simonsilvalauinger/lamellen/hardware/export/stirn/lamellen_stirn_baugruppe.step

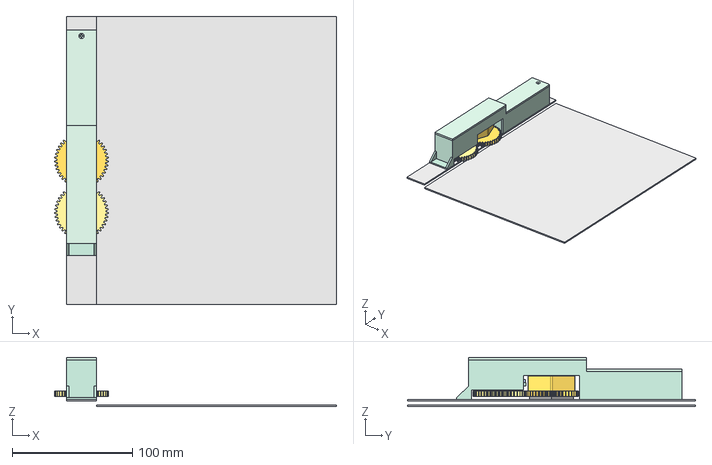
[picture p5: CAD file, 2026-10-22]
hardware/export/stirn/lamellen_stirn_baugruppe.step
235.0 x 240.0 x 41.0 mm
