simonsilvalauinger/lamellen/hardware/export/kalibrierung/huelse_breite.3mf

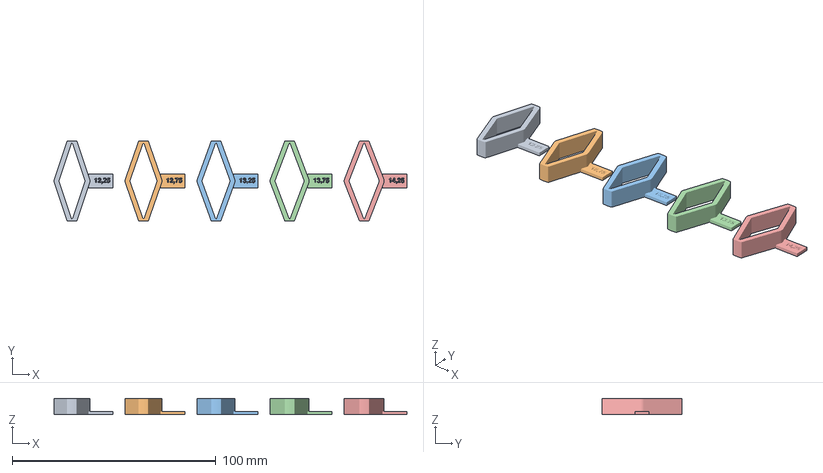
[picture p6: CAD file, 2026-10-22]
hardware/export/kalibrierung/huelse_breite.3mf
173.2 x 39.5 x 8.00 mm
huelse_breite_12_25
huelse_breite_12_75
huelse_breite_13_25
huelse_breite_13_75
huelse_breite_14_25
