simonsilvalauinger/lamellen/hardware/export/kalibrierung/stl/huelse_breite_12_75.stl

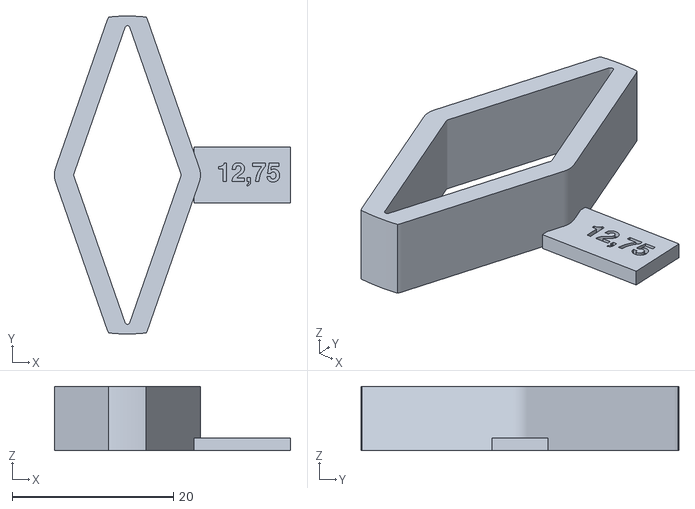
[picture p7: CAD file, 2026-10-22]
hardware/export/kalibrierung/stl/huelse_breite_12_75.stl
29.3 x 39.5 x 8.00
