simonsilvalauinger/lamellen/hardware/export/stirn/step/ritzel.step

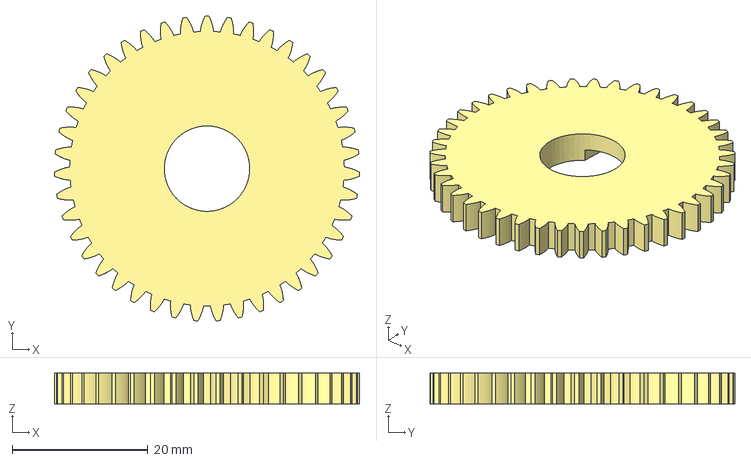
[picture p8: CAD file, 2026-10-22]
hardware/export/stirn/step/ritzel.step
45.0 x 45.0 x 4.50 mm
