simonsilvalauinger/lamellen/hardware/export/kalibrierung/huelse_laenge.3mf

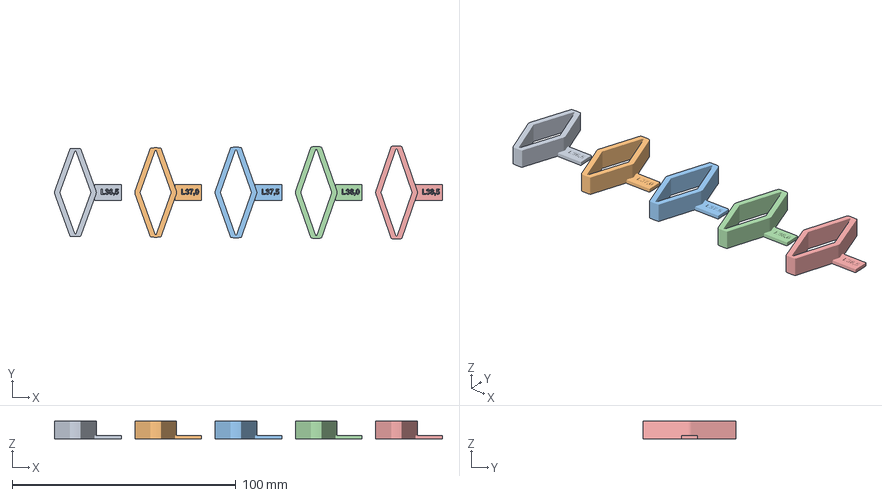
[picture p9: CAD file, 2026-10-22]
hardware/export/kalibrierung/huelse_laenge.3mf
173.2 x 41.5 x 8.00 mm
huelse_laenge_36_50
huelse_laenge_37_00
huelse_laenge_37_50
huelse_laenge_38_00
huelse_laenge_38_50
