simonsilvalauinger/lamellen/hardware/export/kalibrierung/stl/huelse_laenge_38_50.stl

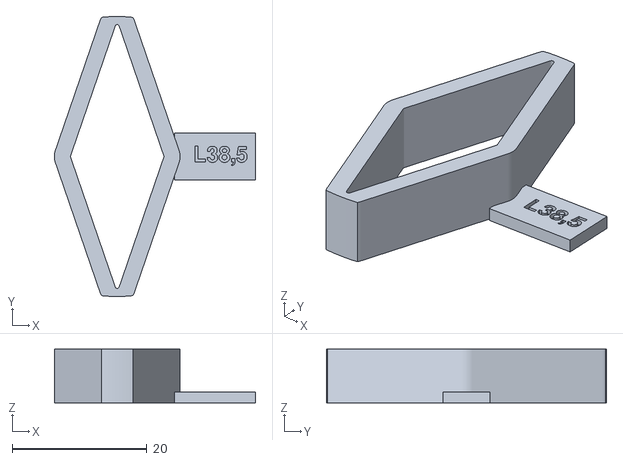
[picture p10: CAD file, 2026-10-22]
hardware/export/kalibrierung/stl/huelse_laenge_38_50.stl
29.8 x 41.5 x 8.00
