simonsilvalauinger/lamellen/hardware/export/stirn/lamellen_stirn.3mf

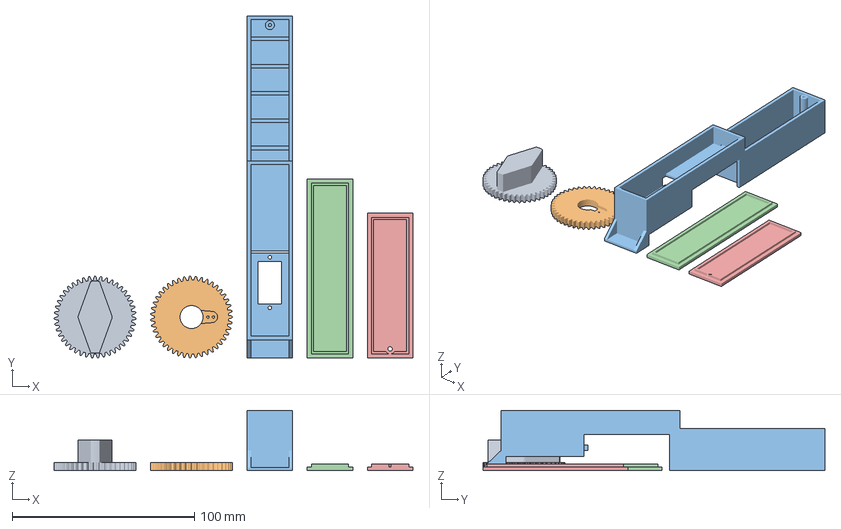
[picture p11: CAD file, 2026-10-22]
hardware/export/stirn/lamellen_stirn.3mf
196.9 x 187.8 x 33.0 mm
mitnehmer
ritzel
gehaeuse
deckel_turm
deckel_akku
