simonsilvalauinger/lamellen/hardware/export/stirn/step/gehaeuse.step

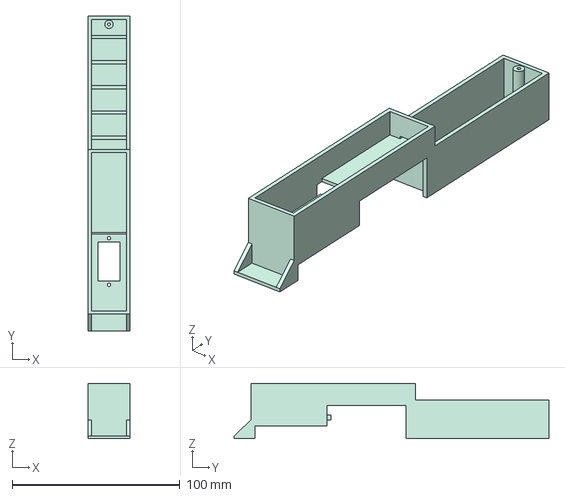
[picture p12: CAD file, 2026-10-22]
hardware/export/stirn/step/gehaeuse.step
25.0 x 187.8 x 33.0 mm
