simonsilvalauinger/lamellen/hardware/export/kalibrierung/stl/huelse_breite_13_75.stl

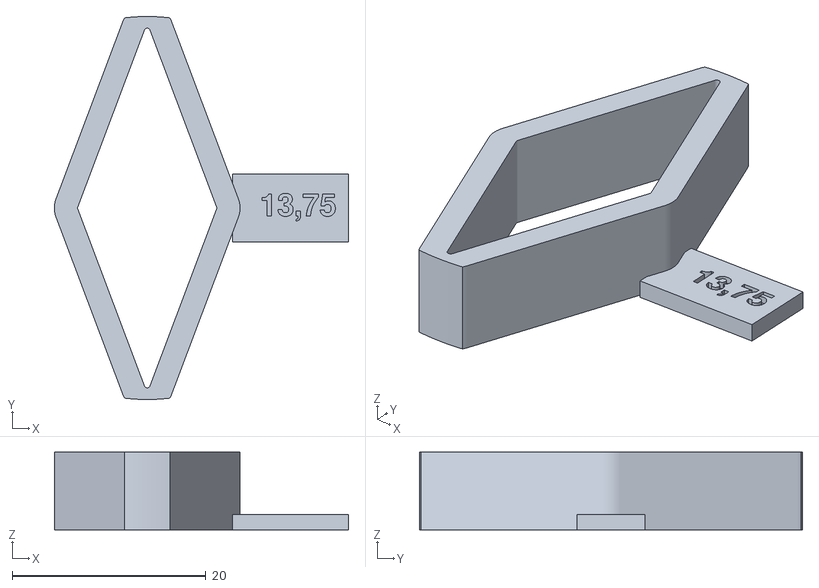
[picture p13: CAD file, 2026-10-22]
hardware/export/kalibrierung/stl/huelse_breite_13_75.stl
30.3 x 39.5 x 8.00
