simonsilvalauinger/lamellen/hardware/export/stirn/step/mitnehmer.step

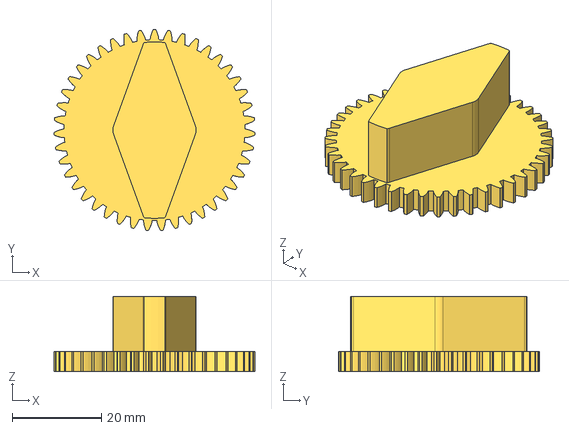
[picture p14: CAD file, 2026-10-22]
hardware/export/stirn/step/mitnehmer.step
45.0 x 45.0 x 16.8 mm
