simonsilvalauinger/lamellen/hardware/export/stirn/step/deckel_turm.step

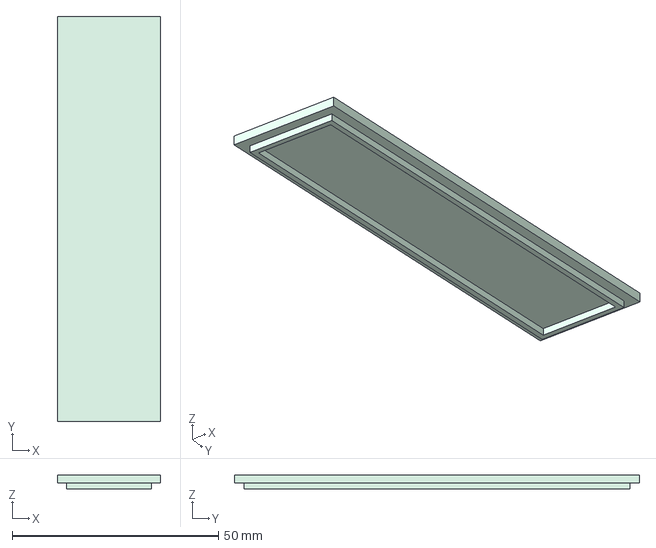
[picture p15: CAD file, 2026-10-22]
hardware/export/stirn/step/deckel_turm.step
25.0 x 98.2 x 3.50 mm
