simonsilvalauinger/lamellen/hardware/export/stirn/step/deckel_akku.step

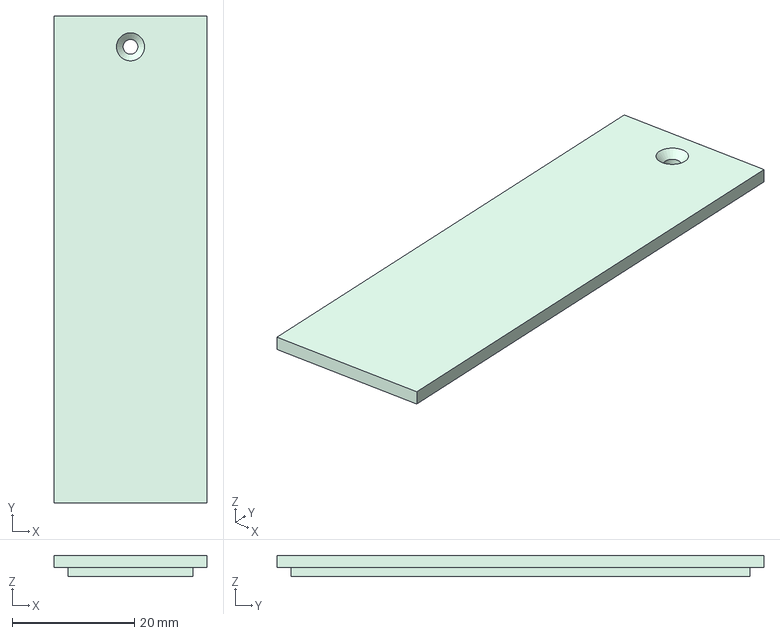
[picture p16: CAD file, 2026-10-22]
hardware/export/stirn/step/deckel_akku.step
25.0 x 79.5 x 3.50 mm
