simonsilvalauinger/lamellen/hardware/export/kalibrierung/stl/huelse_breite_14_25.stl

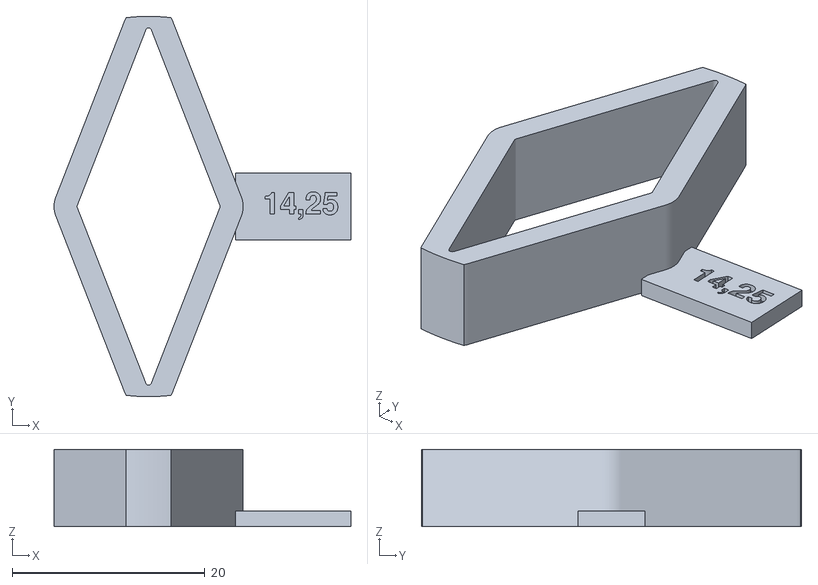
[picture p17: CAD file, 2026-10-22]
hardware/export/kalibrierung/stl/huelse_breite_14_25.stl
30.8 x 39.5 x 8.00
