simonsilvalauinger/lamellen/(list of files, cad)

Other CAD files:
hardware/export/kalibrierung/stl/huelse_breite_12_25.stl
hardware/export/kalibrierung/stl/huelse_breite_13_25.stl
hardware/export/kalibrierung/stl/huelse_laenge_36_50.stl
hardware/export/kalibrierung/stl/huelse_laenge_38_00.stl
hardware/export/kalibrierung/stl/huelse_laenge_37_00.stl
hardware/export/kalibrierung/stl/huelse_laenge_37_50.stl
hardware/export/stirn/stl/deckel_akku.stl
hardware/export/stirn/stl/deckel_turm.stl
hardware/export/stirn/stl/gehaeuse.stl
hardware/export/stirn/stl/mitnehmer.stl
hardware/export/stirn/stl/ritzel.stl
