simonsilvalauinger/lamellen/(commit log)

2026-10-21 Lösungskonzept für HA-gesteuerte Lamellen der Warmluftheizung
    Claude-Session: https://claude.ai/code/session_01V2ShDL9xXnCPpknpFR2EBe
2026-10-21 Knoten-Firmware (ESP32-C6, ESP-NOW, Deep-Sleep), Protokoll-Crate und OpenSCAD-Aktor
    - firmware/protocol: Nachrichten, Servo-Mathematik, Sicherheitslogik mit Tests
    - firmware/node: Status senden, Sollwert empfangen, Servo rampen, Deep-Sleep
    - hardware/lamellen_aktor.scad: parametrischer Mitnehmer für den Flügelmutter-Knopf,
    1:3-Getriebe, Halter für geklemmte Gitter
    - Konzept auf 45°-Drehknopf und geklemmte Gitter aktualisiert
    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
    [lamellen_aktor.scad]
2026-10-22 Aktor an echtes Gitter angepasst: Aufbau entlang des Rahmenrands
    Der Knopf sitzt auf dem Rahmenrand eines Edelstahlgitters, daneben steht
    teils ein Möbel. Neue Variante „direkt“ (Servo koaxial, Standard) und
    „getriebe“ mit Zahnsegment statt Vollzahnrad; Füße auf dem Rahmenrand,
    Befestigung per VHB. Servo-Standardwerte auf 45° Direktantrieb angepasst.
    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
    [lamellen_aktor.scad]
2026-10-22 Mitnehmer als Rautenhülse für den 35 × 9 mm Drehknopf
    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
    [lamellen_aktor.scad]
2026-10-22 Gemessene Knopfhöhe (15 mm) übernommen, Hülse greift 10 mm über
    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
    [lamellen_aktor.scad]
2026-10-22 Auf 180° Knopfweg umgestellt
    Der Knopf dreht 180° (Lamellen ca. 75°). Variante „direkt“ nutzt den vollen
    MG90S-Stellbereich, „getriebe“ wird zu 270°-Servo mit 1:1,5. Rautenhülse
    auf den Drehkreis des Knopfs begrenzt. Servo-Standardwerte 600/2400 µs.
    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
    [lamellen_aktor.scad]
2026-10-22 Rahmenrand 25 mm übernommen, Prüfung der Fußbreite
    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
    [lamellen_aktor.scad]
2026-10-22 Gemeinsames Gehäuse für Servo, Akku und XIAO
    Halter wird zur 25 mm breiten Wanne mit Zwischenboden: Servo über dem Knopf,
    darunter LiPo (oder 18650) und XIAO mit Antenne zur Stirnwand. Luftspalt mit
    Lüftungsschlitzen zum warmen Rahmen, Deckel mit 2 × M2, Klebekante für VHB.
    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
    [lamellen_aktor.scad]
2026-10-22 Gemessenen Platz am Rahmen prüfen, 18650 über dem Servo
    Knopfmitte 107,5 mm über der Rahmenunterkante und 120 mm unter der Oberkante.
    Mit 18650 liegt der Akku über dem Servo; OpenSCAD meldet, wenn das Gehäuse
    über den Rahmen ragen würde.
    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
    [lamellen_aktor.scad]
2026-10-22 Gestuftes Gehäuse: nur der Servoturm ist hoch
    Akku (oben) und Elektronik (unten) liegen flach auf dem Rahmen statt auf dem
    Zwischenboden. Kabel laufen über Schächte an den Turmenden und nie durch den
    Drehbereich. 18650 ist jetzt Standard und passt mit 112/88,5 mm auf den Rahmen.
    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
    [lamellen_aktor.scad]
2026-10-22 Variante „kegel“: liegender Servo mit Kegelradpaar 1:1
    Servoturm sinkt von 55 auf 39 mm. Ein Kronenrad wurde verworfen, weil seine
    Zähne bei 1:1 innen vollständig unterschnitten werden; zwei gleiche Kegelräder
    lenken stattdessen um 90° um. Kollisionsprüfung über 180° Knopfweg, Servobett
    mit Anschlägen, Niederhalter im Turmdeckel. Standardvariante ist jetzt „kegel“.
    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
    [lamellen_aktor.scad]
2026-10-22 Variante „stirn“: Zahnkranz an der Hülse, Servo kopfüber
    Die Hülse trägt einen Zahnkranz direkt über dem Rahmen, das Ritzel eines
    kopfüber stehenden MG90S greift 1:1 ein. Servoturm 35 mm, Gehäuse 187 mm,
    Servo mit Laschen verschraubt; Platine und XIAO auf einer Ablage über der
    Hülse. Die Zahnräder ragen 9,5 mm über den Rahmenrand. Neuer Standard.
    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
    [lamellen_aktor.scad]
2026-10-22 Exporte für Bambu Studio (3MF/STL) und Onshape (STEP)
    tools/export.py rendert die Teile mit OpenSCAD, legt sie für den A1 auf eine
    Platte (3MF) und wandelt sie mit OpenCascade in benannte, eingefärbte
    STEP-Volumenkörper in Einbaulage um (ebene Facetten zusammengefasst).
    Exporte der Standardvariante liegen in hardware/export/stirn/.
    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
    [deckel_akku.step, deckel_akku.stl, deckel_turm.step, deckel_turm.stl, gehaeuse.step, gehaeuse.stl, lamellen_aktor.scad, lamellen_stirn.3mf]
2026-10-22 Exaktes CAD-Modell der Variante „stirn“ (CadQuery)
    cad/lamellen.py baut Hülse mit Zahnkranz, Ritzel, Gehäuse und Deckel als
    B-Rep nach: echte Zylinder, Evolventenflanken als Splines. Die STEP-Exporte
    für Onshape kommen jetzt daraus (8 statt 22 MB, 192 statt 996 Flächen an der
    Hülse). tools/check_cad.py vergleicht beide Modelle über die Volumina und
    prüft Zahneingriff, Drehweg und Passungen.
    Dabei gefunden und in beiden Modellen behoben: der Steg unter den
    Fachdeckeln stieß 1,2 mm in den Schraubdom.
    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
    [deckel_akku.step, deckel_akku.stl, deckel_turm.step, deckel_turm.stl, gehaeuse.step, gehaeuse.stl, lamellen_aktor.scad, lamellen_stirn.3mf]
2026-10-22 Knopfmaße korrigiert: 10 mm breit, ragt 17 mm heraus
    Beide Modelle angepasst, Exporte und Vorschauen neu erzeugt. „stirn“ bleibt
    35 mm hoch; die übrigen Varianten werden 2 mm höher.
    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
    [deckel_akku.step, deckel_turm.step, gehaeuse.step, gehaeuse.stl, lamellen_aktor.scad, lamellen_stirn.3mf, lamellen_stirn_baugruppe.step, mitnehmer.step]
2026-10-22 Hülse 0,25 mm breiter nach Passprobe
    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
    [deckel_akku.step, deckel_turm.step, gehaeuse.step, lamellen_aktor.scad, lamellen_stirn.3mf, lamellen_stirn_baugruppe.step, mitnehmer.step, mitnehmer.stl]
2026-10-22 Kalibrierserie für die Passform der Hülse
    Fünf offene Hülsenringe ohne Zahnkranz mit knob_w 10,00–11,00 mm in
    0,25-mm-Schritten, Wert in die Lasche graviert, als 3MF auf einer Platte.
    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
    [huelse_10_00.stl, huelse_10_25.stl, huelse_10_50.stl, huelse_10_75.stl, huelse_11_00.stl, huelse_passprobe.3mf]
2026-10-22 Hülse 2,25 mm breiter (knob_w 12,25), Kalibrierserie um den aktuellen Wert
    knob_w in beiden Modellen auf 12,25 mm. Die Kalibrierserie legt sich jetzt
    automatisch um den aktuellen Wert (± 1 mm in 0,5-mm-Schritten: 11,25–13,25).
    Exporte und Kalibrier-3MF neu erzeugt.
    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
    [deckel_akku.step, deckel_turm.step, gehaeuse.step, huelse_10_00.stl, huelse_10_25.stl, huelse_10_50.stl, huelse_10_75.stl, huelse_11_00.stl]
2026-10-22 Breite 13,25 aus der Kalibrierung, Längenserie für die Hülse
    knob_w = 13,25 (Breitenserie), knob_len = 36,5 (mindestens 1,5 mm zu kurz).
    Neue Längenserie 36,5–38,5 mm, Gravur „L36,5“ usw. Die Zähnezahl von
    Zahnkranz und Ritzel ergibt sich jetzt in beiden Modellen aus der
    Knopflänge (jetzt 43), damit der Zahnkranz die Hülse immer umschließt.
    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
    [deckel_akku.step, deckel_akku.stl, deckel_turm.step, deckel_turm.stl, gehaeuse.step, gehaeuse.stl, huelse_11_25.stl, huelse_11_75.stl]
